EE463-Project-Group/EE463-Hardware-Project-2025/README.md

# EE 463 Hardware Project

## DC Motor Drive

**Partners:** 
- Kaan Demirkoparan
- Metin Özdemir
- Ali Tarık Birsoy
