EE463-Project-Group/EE463-Hardware-Project-2025/[01]Researches/Links.md

# Research Links:
---

## Homemade E-Bike Brushed DC Motor ESC | 36V Speed Controller:

- https://www.youtube.com/watch?v=GtXMHM78Xbo
- https://electronoobs.com/eng_arduino_tut126.php

---

## Homemade digital power supply with Arduino:

- https://www.youtube.com/watch?v=SAUsIR3VoN4
- https://electronoobs.com/eng_arduino_tut85.php

---

## Motor Speed Controller:

- https://tronicspro.com/dc-motor-speed-controller-150w-diy/

---

## Motor Speed Controller with Arduino:

- https://www.instructables.com/DIY-High-Current-Motor-Driver-h-bridge/?utm_source=chatgpt.com
- https://www.bristolwatch.com/ele5/index0.htm
- https://www.homemade-circuits.com/treadmill-motor-speed-controller-circuit/
- https://www.hackster.io/tareqwaleed1996/pid-speed-controller-for-dc-motor-74e735
- https://www.youtube.com/watch?v=RZIfzPwglOo
- https://www.youtube.com/watch?v=PlZitQysnUg&t=294s
- https://www.powerelectronicsnews.com/powerful-isolated-h-bridge-dc-motor-driver/
- https://www.youtube.com/watch?v=d0r-Yx9R3Zs&list=WL&index=8

### MC-2100 Motor Controller:

- https://forum.arduino.cc/t/another-treadmill-controller-question/676459/4
- https://sonsofinvention.wordpress.com/tag/mc-2100-motor-controller/
- https://www.dropbox.com/scl/fi/tmqcscf03akpz0rzh73zp/MC2100_rev_engrd.pdf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

### IR2110 Gate Driver:

- https://olegkutkov.me/2018/08/01/powerful-dc-motor-driver-using-ir2110/
- https://www.xecor.com/blog/ir2110-datasheet-pinout-features-and-applications
- https://www.youtube.com/watch?v=d0r-Yx9R3Zs&list=WL&index=8
- https://electronics.stackexchange.com/questions/229334/does-the-ir2110-need-a-gate-resistor

---

# Brushed DC Servo Drive:

- https://hackaday.io/project/9433-brushed-dc-servo-drive
- https://github.com/ottoragam/Tarocco
- 

---

## Arduino Library:

- https://github.com/ArminJo/PWMMotorControl
- https://github.com/evanlivingston/MC-2100-motor-speed-controller

## HV Floating MOS-Gate Driver ICs
- https://www.infineon.com/assets/row/public/documents/24/42/infineon-hv-floating-mos-gate-drivers-applicationnotes-en.pdf

## Motor Speed And Current Control:

- https://sites.google.com/site/hobbydebraj/dc-motor-control-using-back-emf-sen
- https://www.youtube.com/watch?v=QSIksPKndEs
- https://www.youtube.com/watch?v=HRaZLCBFVDE&t=157s
- https://www.youtube.com/watch?v=GqsONhTx7l0
- https://www.youtube.com/watch?v=DAeiA4D0j_I
- 

## Not Related But Could Be Useful:

- https://tronicspro.com/12v-220v-h-bridge-inverter-diy-homemade/
- https://www.hackster.io/saulius-bandzevicius/arduino-based-universal-ac-motor-speed-controller-a4ceaf
- https://www.youtube.com/watch?v=HRaZLCBFVDE
