EE463-Project-Group/EE463-Hardware-Project-2025/[01]Researches/image.png

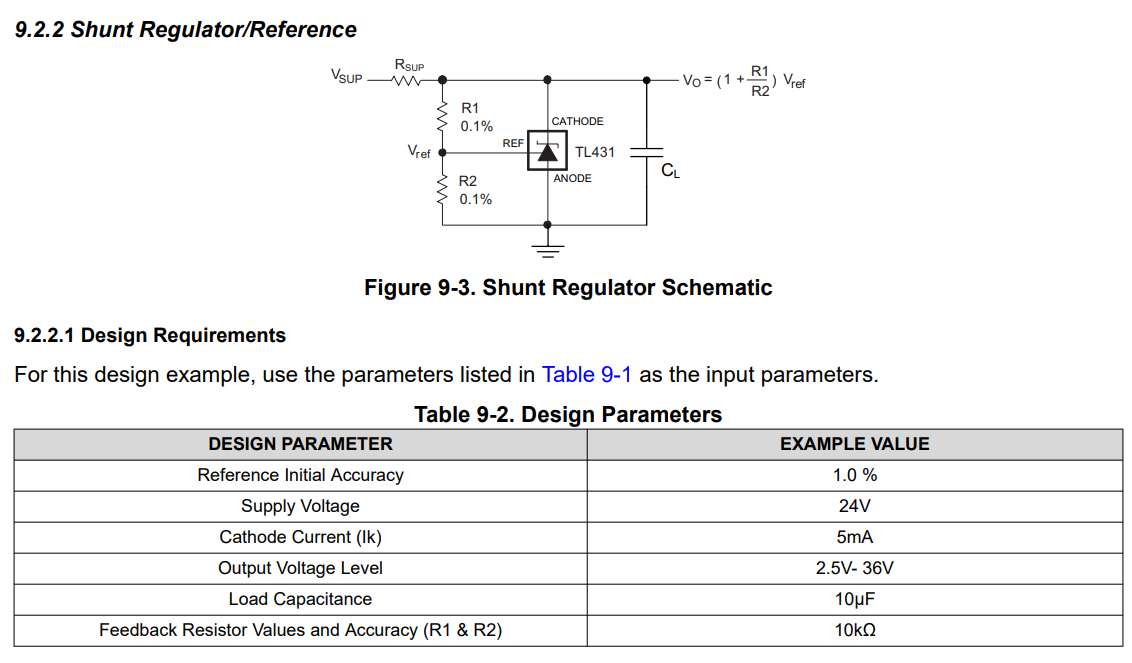
[01]Researches/image.png
