EE463-Project-Group/EE463-Hardware-Project-2025/[01]Researches/Component ReQ & List.md

# Mosfet (H Bridge):

## Requirements:
- For 180V motor Vds> 180v, but for voltage spikes and bemf reasons minimum %20 safety margin: Vds> 216V . But preferably Vds> 300V.
- For 2kw tea bonus: Id> 11A. Starting current etc. %200 safety margin: Id> 22A
- For 20KHz switching frequency: preferably Qg<100nC (https://gemini.google.com/share/17e45798b182)

## Models:
- IRF640N
  - https://www.infineon.com/assets/row/public/documents/24/49/infineon-irf640n-datasheet-en.pdf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
- IRFP250
  - https://www.vishay.com/docs/91212/irfp250.pdf
- PJMP120N60EC
  - 63 TL
  - https://www.ozdisan.com/api/pdf/product/assets/PANJIT_PJMP120N60EC.pdf
  - https://www.ozdisan.com/p/discrete-mosfetler-435/panjit-pjmp120n60ec-t0-00001-954296
- PJMH099N60EC
  - 74 TL
  - https://www.ozdisan.com/api/pdf/product/assets/PANJIT_PJMH099N60EC.pdf
  - https://www.ozdisan.com/p/discrete-mosfetler-435/panjit-pjmh099n60ec-995057
- PJMH074N60FRC
  - 129 TL
  - https://www.ozdisan.com/api/pdf/product/assets/PANJIT_PJMH074N60FRC.pdf
  - https://www.ozdisan.com/p/discrete-mosfetler-435/panjit-pjmh074n60frc-995056
- 
  -
- ASL101215
  -https://www.hatfon.com/urun/trafo-asl-101215-0-5va-2x15v-230v-aslan
  -https://www.pttavm.com/trafo-asl-0-5va-2x15-aslan-230v-p-114325137 (alternatif link)
  -
- 
  -
- 
  -
- 
  -
- 
  -
# Gate Driver:
## Models:
- IR2110
  - 57 TL (DIP)
  - https://www.motorobit.com/ir2110-dip-14-mosfet-driver-ic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
  - 36 TL (SMD)
  - https://www.ozdisan.com/p/guc-surucu-entegreleri-270/infineon-ir2110strpbf-483809
  - https://www.danomsk.ru/upload/iblock/01c/74860_0d2671659de625a9213c07e20588b5fd.pdf
