EE463-Project-Group/EE463-Hardware-Project-2025/[05]Docs/BOM List.xlsx

Model Name | Link | Price | Number For One Set | Number of Sets | Extra | Total Number | Total Price For Each Model | Datasheet Link
PJMH099N60EC | https://www.ozdisan.com/p/Discrete-Mosfets-435/panjit-pjmh099n60ec-995057 | 74.72 | 4 | 2 | 2 | 10 | ₺747.20 | PANJIT_PJMH099N60EC.pdf (https://www.ozdisan.com/api/pdf/product/assets/PANJIT_PJMH099N60EC.pdf)
MUR840 | https://www.komponentci.net/mur860-8a-600v-hizli-diyot-to-220ac-pmu10991 | 25.57 | 4 | 2 | 0 | 8 | ₺204.56 | MUR840, MUR860, RURP840, RURP860 8A, 400V - 600V Ultrafast Diodes (https://www.mouser.com/datasheet/2/149/rurp860-244175.pdf)
UF4007 | https://www.direnc.net/uf4007-10-amp-ultra-fast-rectifiers | 1.02 | 6 | 2 | 5 | 17 | ₺17.34 | uf4001.pdf (https://www.vishay.com/docs/88755/uf4001.pdf)
ADUM1200ARZ | ADUM1200ARZ-RL7 SOIC-8 2 Kanal İzolatör Entegresi ACS/AD/ADC Serisi Motorobit - Motorobit.com (https://www.motorobit.com/adum1200arz-rl7-soic-8-2-kanal-izolator-entegresi) | 104.4 | 2 | 1 | 1 | 3 | ₺313.20 | ADuM1200/ADuM1201 (Rev.K) (https://dosya.motorobit.com/pdf/ADUM1200ARZ.pdf)
Hall Effect Sensör | Hall Effect Sensör Kartı Manyetik Robolink (https://www.robolinkmarket.com/hall-effect-sensor-karti) | 14.4 | 1 | 1 | 1 | 2 | ₺28.80
5V 2A Adaptör | https://www.hepsiburada.com/oem-sl-1255-5v-2a-luks-filter-tablet-pc-adaptoru-p-HBCV00003ZC75G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 | 179.57 | 1 | 1 | 0 | 1 | ₺179.57
15V Adaptör |  |  |  |  |  | 0 | ₺0.00
18V 1A Adaptör | https://www.egbelektronik.com/urun/weko-18-volt-1-amper-5525-ulu-yerli-retim-priz-tipi-adaptr-11106511 | 98.14 | 4 | 1 | 0 | 4 | ₺392.56
1500 uF 400V C | 1500uF 400V Elektrolitik Kondansatör 35x82mm Elektrolit Kondansatör Motorobit - Motorobit.com (https://www.motorobit.com/1500uf-400v-elektrolitik-kondansator-35x82mm) | 448.92 | 1 | 1 | 1 | 2 | ₺897.84
0.1 uF 1kV C | RDER73A104K5B1H03B Murata - Kapasitörler - e-komponent.com (https://www.e-komponent.com/01-f-10-1000v-1kv-ceramic-capacitor) | 86.16 | 2 | 1 | 2 | 4 | ₺344.64
1N4118 Diyot | 1N4148 Diyot - MIC Uygun Fiyatıyla Satın Al - Direnc.net® (https://www.direnc.net/1n4148-diyot-mic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) | 0.41 | 2 | 1 | 5 | 7 | ₺2.87
100 nF C | 100nF 63V 5mm %5 Polyester Kondansatör Uygun Fiyatıyla Satın Al - Direnc.net® (https://www.direnc.net/100nf-63v-polyster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) | 1.78 | 13 | 1 | 10 | 23 | ₺40.94
10 uF | 10uF 100V Kondansatör 5x11mm Uygun Fiyatıyla Satın Al - Direnc.net® (https://www.direnc.net/10uf100v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) | 1.17 | 2 | 1 | 5 | 7 | ₺8.19
100uF | 100uF 16V Kondansatör 5mm 5x11mm 2000Hrs Uygun Fiyatıyla Satın Al - Direnc.net® (https://www.direnc.net/100uf-16v-kondansator-5x11-12485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) | 1.19 | 4 | 1 | 12 | 16 | ₺19.04
22uF (10 adet) | https://www.robolinkmarket.com/22uf-35v-kondansator-paketi-10-adet | 14.4 | 1 | 1 | 0 | 1 | ₺14.40
10k direnç (50 adet) | 10K 1/4W Direnç Uygun Fiyatıyla Satın Al - Direnc.net® (https://www.direnc.net/10k-14w-direnc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) | 0.15 | 1 | 1 | 29 | 30 | ₺4.50
10 ohm (50 adet) | 10R 1/4W Direnç Uygun Fiyatıyla Satın Al - Direnc.net® (https://www.direnc.net/10r-14w-direnc) | 0.15 | 4 | 1 | 46 | 50 | ₺7.50
1k (50 adet) | 1K 1/4W Direnç Uygun Fiyatıyla Satın Al - Direnc.net® (https://www.direnc.net/1k-14w-direnc) | 0.15 | 1 | 1 | 49 | 50 | ₺7.50
bc547 transistor (4 adet) | BC547- 100mA 45V TO92 NPN Transistörü Satın Al (https://www.robotistan.com/bc547-to92) | 1.55 | 2 | 1 | 4 | 6 | ₺9.30
27k direnç (50 adet) | 27K 1/4W Direnç Uygun Fiyatıyla Satın Al - Direnc.net® (https://www.direnc.net/27k-14w-direnc) | 0.15 | 1 | 1 | 49 | 50 | ₺7.50
560 ohm (50 adet) | https://www.direnc.net/560r-14w-direnc?language=tr&h=5f36deb5 | 0.15 | 4 | 1 | 46 | 50 | ₺7.50
IR2110 | IR2110 Mosfet Sürücü Entegresi Dip-14 | Komponentci (https://www.komponentci.net/ir2110-mosfet-surucu-entegresi-dip-14-pmu8539) | 80.13 | 2 | 1 | 6 | 8 | ₺641.04
acs712 | https://www.robotistan.com/acs712-akim-sensoru-current-sensor-carrier-30-to-30a?language=tr&h=4d66867c | 74.43 | 1 | 1 | 1 | 2 | ₺148.86
6n135 | 6N135 DIP-8 Transistör Çıkışlı Optokuplör Entegresi Uygun Fiyatıyla Satın Al - Direnc.net® (https://www.direnc.net/6n135-high-speed-transistor-optocouplers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) | 24.95 | 2 | 1 | 4 | 6 | ₺149.70
Elektrik Kutusu |  |  |  |  |  | 0 | ₺0.00
230v Plug | https://www.motorobit.com/kulakli-erkek-power-soketi-isikli-anahtarli | 44.37 | 1 | 1 | 0 | 1 | ₺44.37
Buton | https://www.motorobit.com/arduino-5li-buton-modulu | 78.3 | 1 | 1 | 0 | 1 | ₺78.30
Direction Switch | https://www.komponentci.net/ic-140-toggle-switch-on-off-on-6mm-3p-mts-103-pmu6948 | 16.08 | 1 | 1 | 0 | 1 | ₺16.08
On Off Switch 230V | https://www.direnc.net/dc134d-3p-on-off-anahtar-220v-15mm-isikli-yuvarlak?language=tr&h=ff36214d | 23.83 | 1 | 1 | 0 | 1 | ₺23.83
14 pin entegre soketi | https://www.komponentci.net/14-pin-entegre-soketi-pmu3014 | 1.01 | 2 | 1 | 6 | 8 | ₺8.08
8 pin entegre soketi | https://www.komponentci.net/8-pin-entegre-soketi-pmu3015 | 0.88 | 2 | 1 | 4 | 6 | ₺5.28
Total Price Sum |  |  |  |  |  |  | ₺4370.49
Sponsorship Amount |  |  |  |  | $100.00 | 42.54 | ₺4254.00
Net Money |  |  |  |  |  |  | -₺116.49
