EE463-Project-Group/EE463-Hardware-Project-2025/[01]Researches/Component List.xlsx

Ürün Adı | Link | Fiyat | Adet | datasheet link
PJMH099N60EC | https://www.ozdisan.com/p/Discrete-Mosfets-435/panjit-pjmh099n60ec-995057 | 74.7263 | 4*2 | PANJIT_PJMH099N60EC.pdf (https://www.ozdisan.com/api/pdf/product/assets/PANJIT_PJMH099N60EC.pdf)
MUR840 |  |  | 4*3 | MUR840, MUR860, RURP840, RURP860 8A, 400V - 600V Ultrafast Diodes (https://www.mouser.com/datasheet/2/149/rurp860-244175.pdf)
UF4007 |  |  | 6*2 | uf4001.pdf (https://www.vishay.com/docs/88755/uf4001.pdf)
ADUM1200ARZ | ADUM1200ARZ-RL7 SOIC-8 2 Kanal İzolatör Entegresi ACS/AD/ADC Serisi Motorobit - Motorobit.com (https://www.motorobit.com/adum1200arz-rl7-soic-8-2-kanal-izolator-entegresi) | 104.4 | 2 +1 | ADuM1200/ADuM1201 (Rev.K) (https://dosya.motorobit.com/pdf/ADUM1200ARZ.pdf)
Hall Effect Sensör | Hall Effect Sensör Kartı Manyetik Robolink (https://www.robolinkmarket.com/hall-effect-sensor-karti) | 14.4 | 1+1
5V 2A Adaptör
15V Adaptör
18V 1A Adaptör | Uydu Alıcı Sistemleri ve Elektronik Mağazası - Merterelektronik.com (https://www.merterelektronik.com/weko-18-volt-1-amper-priz-tip-5.5x2.5-uc-adaptor) | 144.6 | 1
1500 uF 400V C | 1500uF 400V Elektrolitik Kondansatör 35x82mm Elektrolit Kondansatör Motorobit - Motorobit.com (https://www.motorobit.com/1500uf-400v-elektrolitik-kondansator-35x82mm) | 448.92 | 1+1
0.1 uF 1kV C | RDER73A104K5B1H03B Murata - Kapasitörler - e-komponent.com (https://www.e-komponent.com/01-f-10-1000v-1kv-ceramic-capacitor) | 86.16
1N4118 Diyot | 1N4148 Diyot - MIC Uygun Fiyatıyla Satın Al - Direnc.net® (https://www.direnc.net/1n4148-diyot-mic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) | 0.41 | 2+1
100 nF C | 100nF 63V 5mm %5 Polyester Kondansatör Uygun Fiyatıyla Satın Al - Direnc.net® (https://www.direnc.net/100nf-63v-polyster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) | 1.78 | 13+3
10 uF | 10uF 100V Kondansatör 5x11mm Uygun Fiyatıyla Satın Al - Direnc.net® (https://www.direnc.net/10uf100v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) | 1.17 | 2+1
100uF | 100uF 16V Kondansatör 5mm 5x11mm 2000Hrs Uygun Fiyatıyla Satın Al - Direnc.net® (https://www.direnc.net/100uf-16v-kondansator-5x11-12485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) | 1.19 | 4+1
20uF
10k direnç | 10K 1/4W Direnç Uygun Fiyatıyla Satın Al - Direnc.net® (https://www.direnc.net/10k-14w-direnc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) | 0.15 | 1+1 (min50)
10 ohm | 10R 1/4W Direnç Uygun Fiyatıyla Satın Al - Direnc.net® (https://www.direnc.net/10r-14w-direnc) | 0.15 | 4+1 (min 50)
1k | 1K 1/4W Direnç Uygun Fiyatıyla Satın Al - Direnc.net® (https://www.direnc.net/1k-14w-direnc) | 0.15 | 4+1 (min50)
bc547 transistor | BC547- 100mA 45V TO92 NPN Transistörü Satın Al (https://www.robotistan.com/bc547-to92) | 1.55 | 2+1
27k direnç | 27K 1/4W Direnç Uygun Fiyatıyla Satın Al - Direnc.net® (https://www.direnc.net/27k-14w-direnc) | 0.15 | 1 +1 (min 50)
570 ohm |  |  | 4+1
IR2110 | IR2110 Mosfet Sürücü Entegresi Dip-14 | Komponentci (https://www.komponentci.net/ir2110-mosfet-surucu-entegresi-dip-14-pmu8539) | 80.13 | 2+2
acs712 | ACS712-30A Smd Akım Sensörü Entegresi Soic-8 Uygun Fiyatıyla Satın Al - Direnc.net® (https://www.direnc.net/acs712-30a-smd-akim-sensoru-entegresi-soic8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) | 71.1 | 1+1
6n135 | 6N135 DIP-8 Transistör Çıkışlı Optokuplör Entegresi Uygun Fiyatıyla Satın Al - Direnc.net® (https://www.direnc.net/6n135-high-speed-transistor-optocouplers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) | 24.95 | 2+1
