EE463-Project-Group/EE463-Hardware-Project-2025/.github/commit-instructions.md

Commit mesajlarının daima şu formatta olmasını sağla: [ANA_KLASÖR_ADI]: Açıklayıcı Başlık.
ANA_KLASÖR_ADI, yapılan değişikliklerin en çok bulunduğu klasör olmalıdır (örn: Researches, Designs, Softwares, Simulations).
Açıklayıcı Başlık, daha önceki commitlere benzer şekilde yapılan çalışmayı çok kısa özetleyecek şekilde olmalıdır.
Başlık 50 karakteri geçmemelidir.
