EE463-Project-Group/EE463-Hardware-Project-2025/[02]Designs/KiCad Design/Schematic.pdf

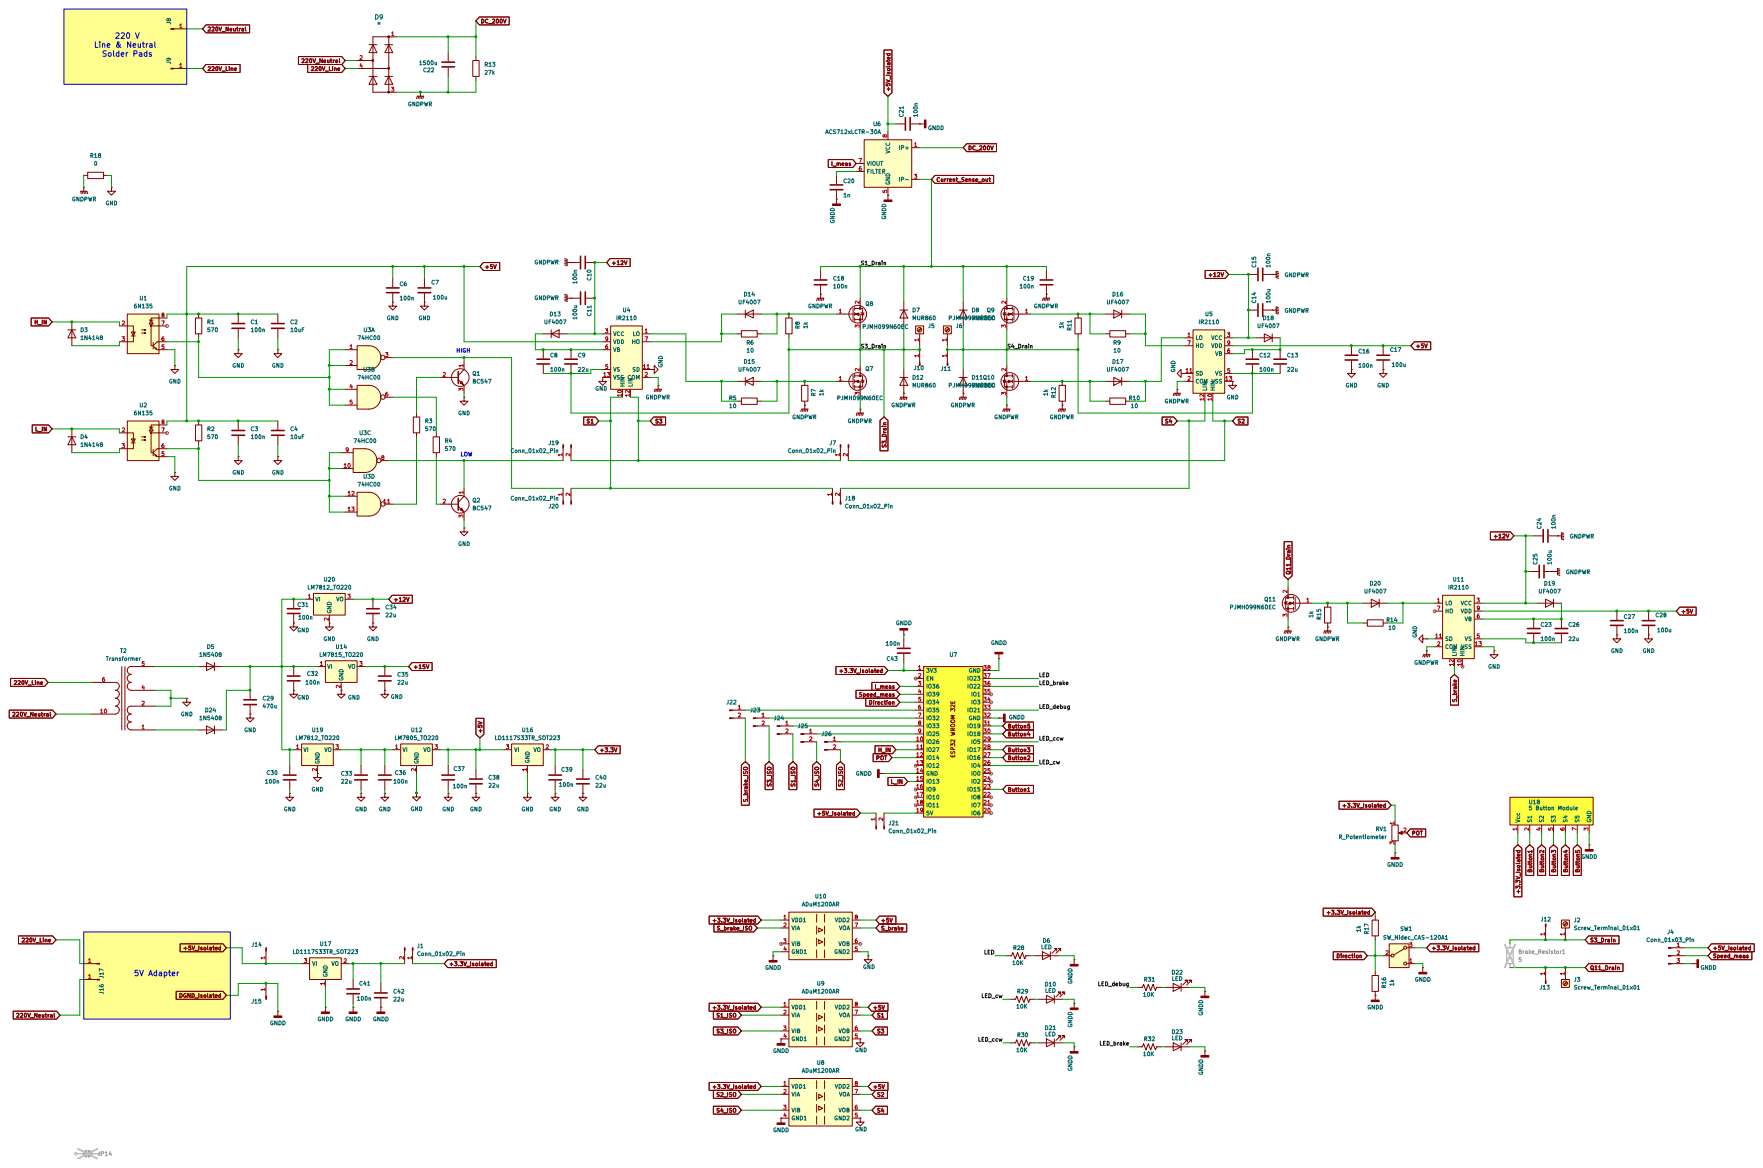
[picture p30: page 1]
