EE463-Project-Group/EE463-Hardware-Project-2025/[04]Simulations/Auxilary Power/low_voltage_gen.asc

C1: cap; 4700µ
C2: cap; 10µ
D1: diode; 1N4007
D2: diode; 1N4007
L1: ind2; 100
L2: ind2; 1
L3: ind2; 1
R1: res; 1
R2: res; 1k
R3: res; 1k
R4: res; 3k
U1: 7805
U2: 7812
U3: 7815
U4: TL431
V1: voltage; SINE(0 200 50)
Named nets: 0, 3.3v, 15v, 5v, 12v
K L1 L2 L3 1
.tran 1
