EE463-Project-Group/EE463-Hardware-Project-2025/[02]Designs/KiCad Design/463 term project.kicad_pcb

## KiCad design [02]Designs/KiCad Design/463 term project.kicad_pcb (2026-01-02)

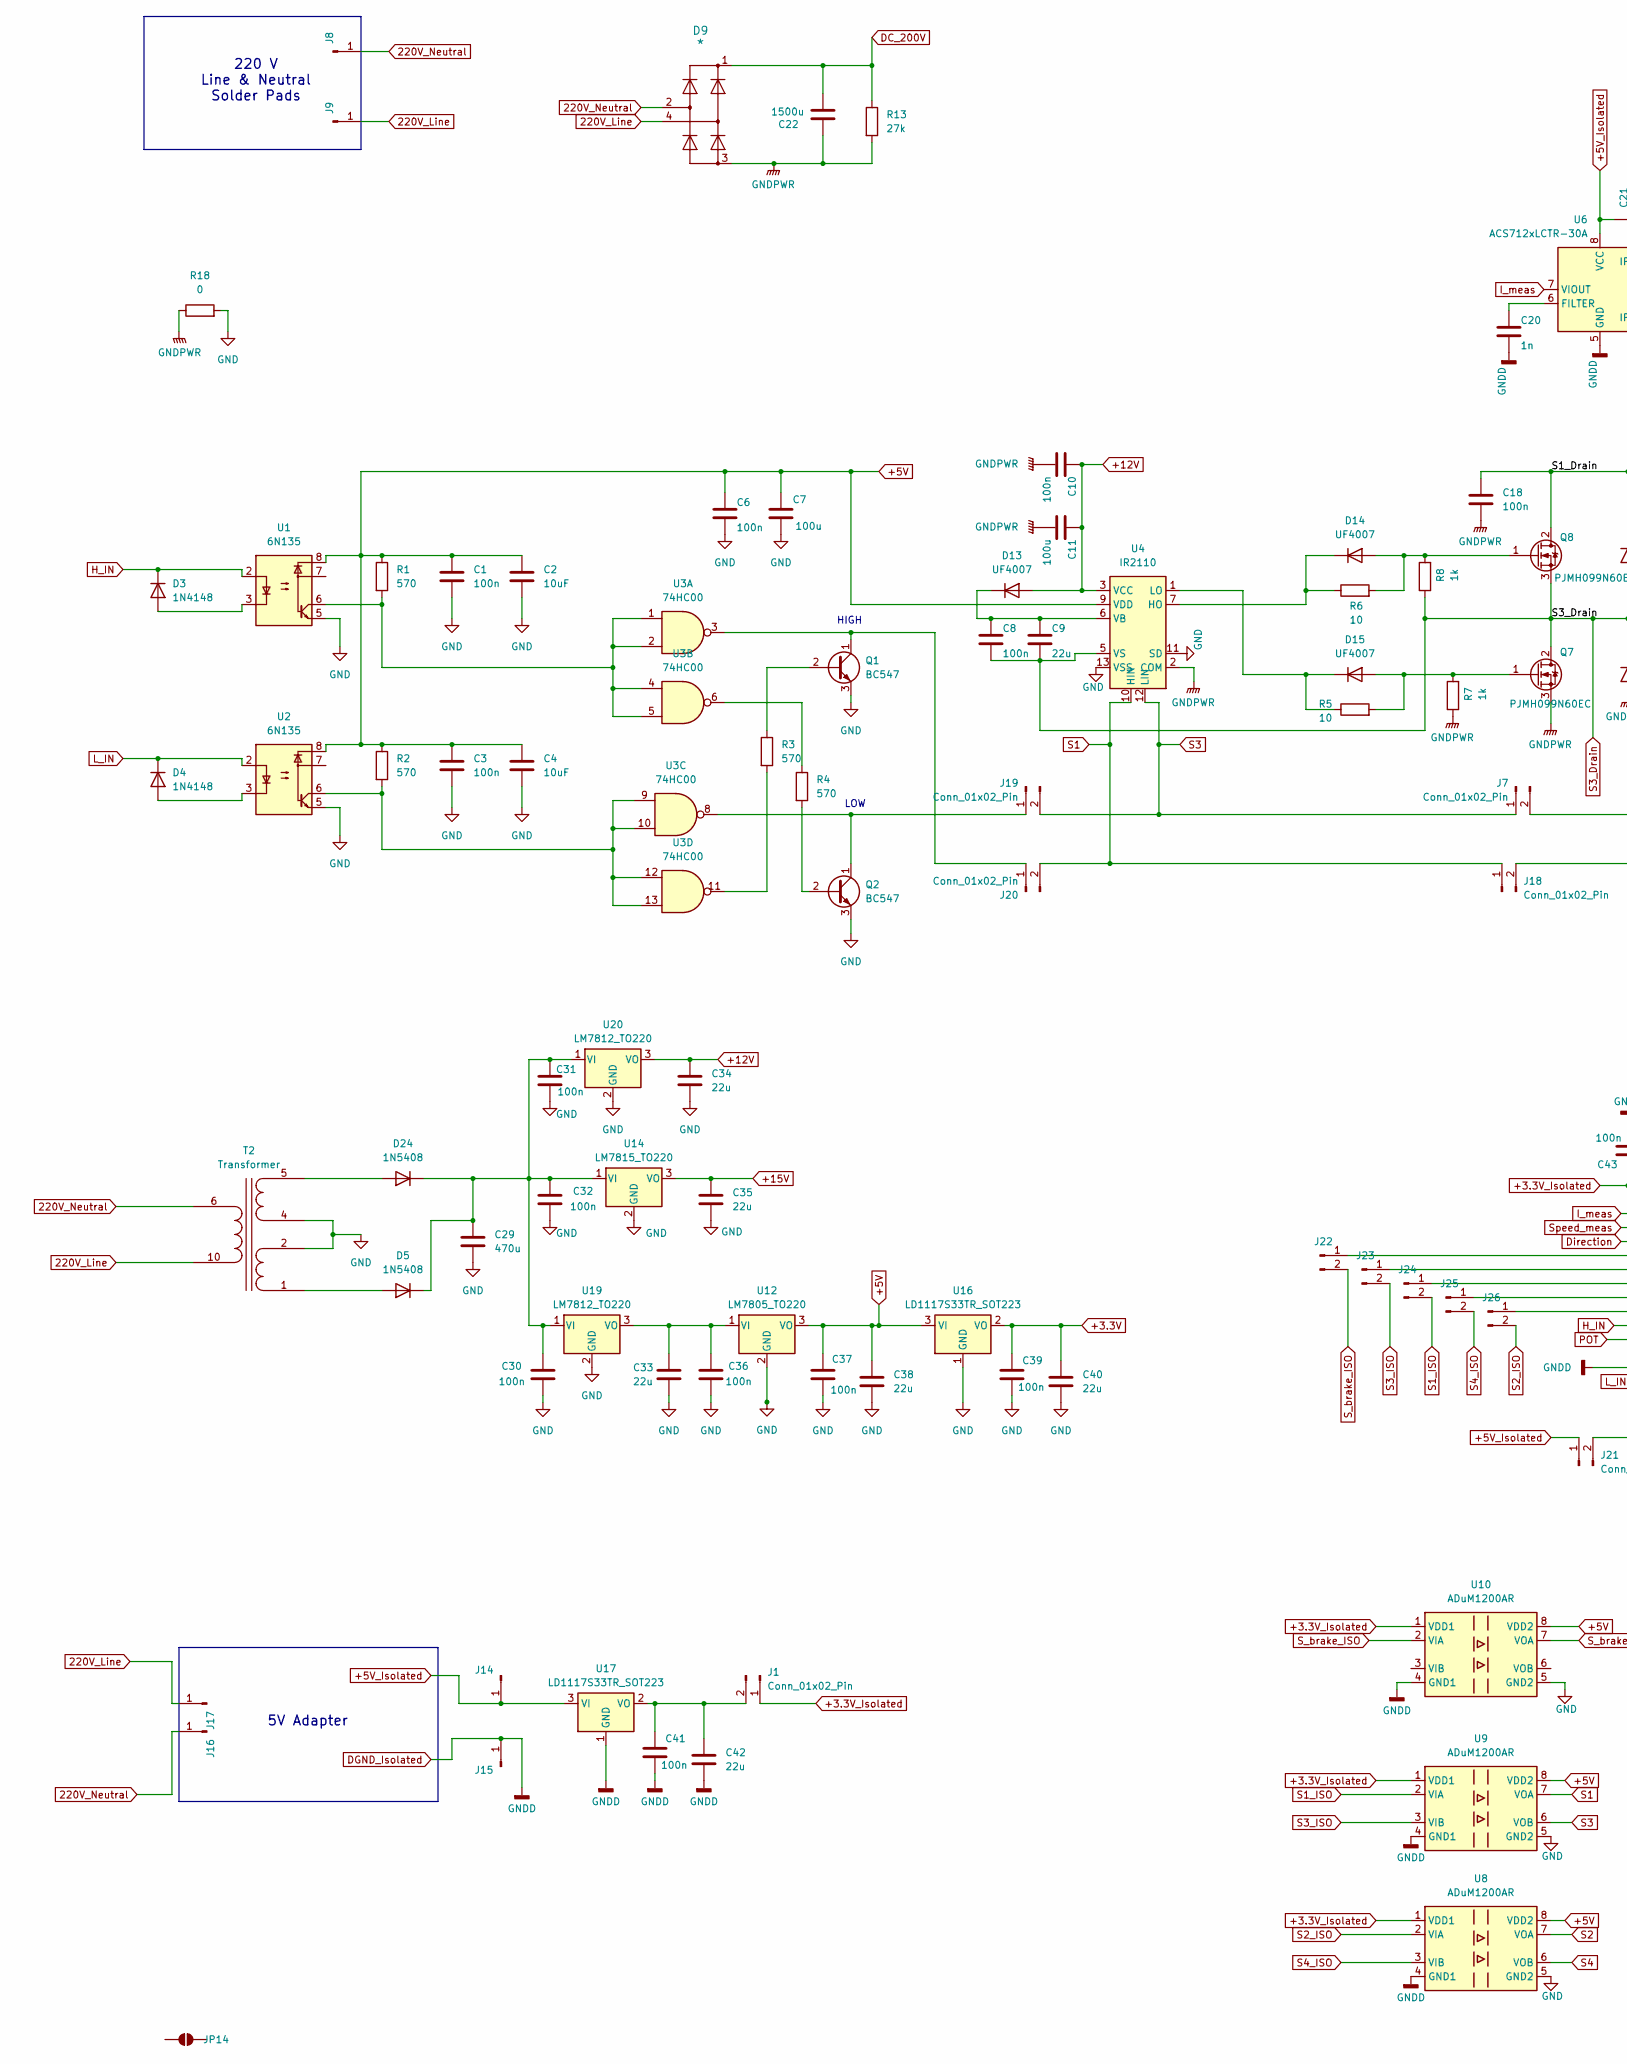
[picture p31: schematic 463 term project.kicad_sch, part in row 1, column 1]

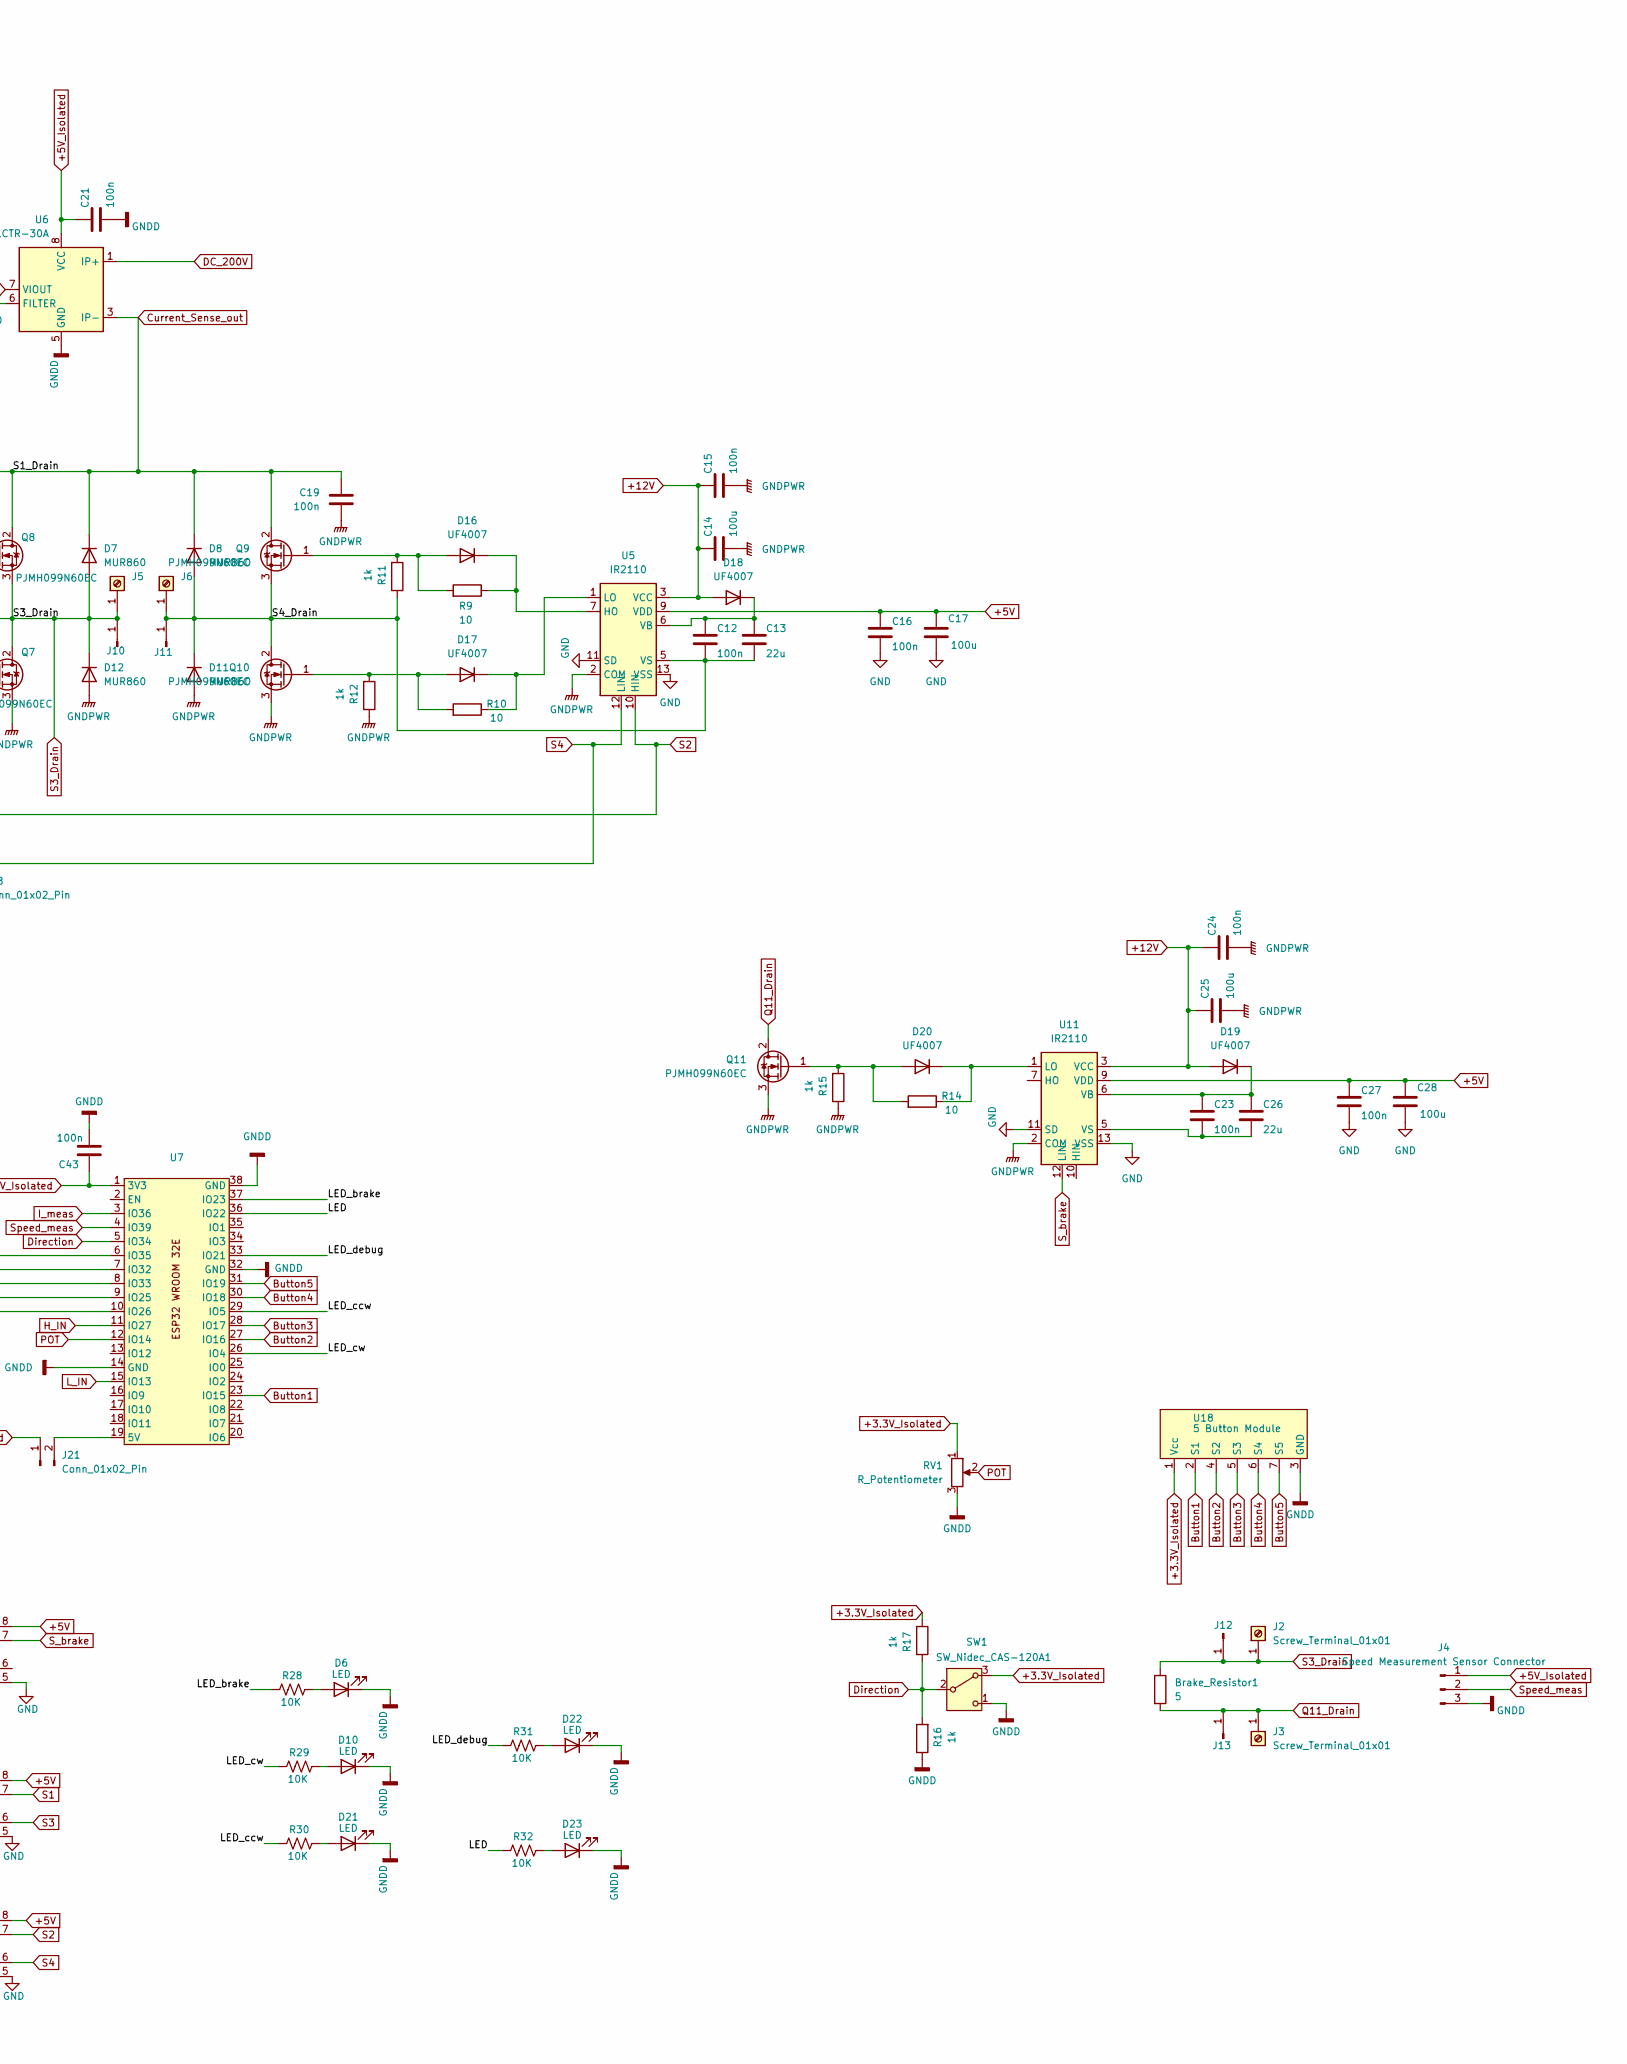
[picture p32: schematic 463 term project.kicad_sch, part in row 1, column 2]

Parts:
Brake_Resistor1: 5
C1, C3, C6, C8, C10, C12, C15, C16, C18, C19, C23, C24, C27, C30, C31, C32, C36, C37, C39, C41, C43: 100n; C_Disc_D5.0mm_W2.5mm_P5.00mm
C2, C4: 10uF; CP_Radial_D6.3mm_P2.50mm
C7, C11, C14, C17, C25, C28: 100u; CP_Radial_D8.0mm_P5.00mm
C9, C13, C26, C33, C34, C35, C38, C40, C42: 22u; CP_Radial_D8.0mm_P5.00mm
C20: 1n; 0603 Large
C21: 100n; 0603 Large
C22: 1500u; 1500uF
C29: 470u; CP_Radial_D10.0mm_P2.50mm
D3, D4: 1N4148; D_DO-35_SOD27_P7.62mm_Horizontal
D5, D24: 1N5408; D_DO-201AD_P15.24mm_Horizontal
D6, D10, D21, D22, D23: LED; 0603 Medium
D7, D8, D11, D12: MUR860; TO-220-2_Vertical
D9: *; KBPC3510FP
D13, D14, D15, D16, D17, D18, D19, D20: UF4007; D_DO-41_SOD81_P10.16mm_Horizontal
J1, J7, J18, J19, J20, J21, J22, J23, J24, J25, J26: Conn_01x02_Pin; PinHeader_1x02_P2.54mm_Vertical
J2, J3, J5, J6: Screw_Terminal_01x01; Untitled
J4: Speed Measurement Sensor Connector; PinHeader_1x03_P2.54mm_Vertical
J8, J9, J10, J11, J12, J13, J16, J17: Conn_01x01_Pin; SolderWirePad_1x01_SMD_5x10mm
J14, J15: Conn_01x01_Pin; SolderWirePad_1x01_SMD_1x2mm
JP14: SolderJumper_2_Open; SolderJumper-2_P1.3mm_Open_TrianglePad1.0x1.5mm
Q1, Q2: BC547; TO-92_Inline
Q7, Q8, Q9, Q10, Q11: PJMH099N60EC; TO-247-3_Vertical
R1, R2, R3, R4: 570; R_Axial_DIN0207_L6.3mm_D2.5mm_P10.16mm_Horizontal
R5, R6, R9, R10, R14: 10; R_Axial_DIN0207_L6.3mm_D2.5mm_P10.16mm_Horizontal
R7, R8, R11, R12, R15, R16, R17: 1k; R_Axial_DIN0207_L6.3mm_D2.5mm_P10.16mm_Horizontal
R13: 27k; R_Axial_DIN0207_L6.3mm_D2.5mm_P10.16mm_Horizontal
R18: 0; R_Axial_DIN0207_L6.3mm_D2.5mm_P10.16mm_Horizontal
R28, R29, R30, R31, R32: 10K; 0603 Medium
RV1: R_Potentiometer; PinHeader_1x03_P2.54mm_Vertical
SW1: SW_Nidec_CAS-120A1; PinHeader_1x03_P2.54mm_Vertical
T2: Transformer; Transformer_Breve_TEZ-35x42
U1, U2: 6N135; DIP-8_W7.62mm
U3: 74HC00; DIP-14_W7.62mm_Socket
U4, U5, U11: IR2110; DIP-14_W7.62mm
U6: ACS712xLCTR-30A; SOIC-8_3.9x4.9mm_P1.27mm
U7: ESP32_WROOM_32X
U8, U9, U10: ADuM1200AR; SOIC-8_3.9x4.9mm_P1.27mm
U12: LM7805_TO220; TO-220-3_Vertical
U14: LM7815_TO220; TO-220-3_Vertical
U16, U17: LD1117S33TR_SOT223; TO-220-3_Vertical
U18: 5 Button Module; 5 button module
U19, U20: LM7812_TO220; TO-220-3_Vertical

Connections:
220V_Line: D9.4 (Input_~), J9.1, J17.1, T2.10 (AB)
220V_Neutral: D9.2 (Input_~), J8.1, J16.1, T2.6 (AA)
+3.3V: C39.1, C40.1, U16.2 (VO)
+3.3V_Isolated: C43.1, J1.1, R17.1, RV1.1, SW1.3 (A), U7.1 (3V3), U8.1 (VDD1), U9.1 (VDD1), U10.1 (VDD1), U18.1 (Vcc)
+5V: C1.1, C2.1, C3.1, C4.1, C6.1, C7.1, C16.1, C17.1, C27.1, C28.1, C37.1, C38.1, R1.1, R2.1, U1.8, U2.8, U4.9 (VDD), U5.9 (VDD), U8.8 (VDD2), U9.8 (VDD2), U10.8 (VDD2), U11.9 (VDD), U12.3 (VO), U16.3 (VI)
+5V_Isolated: C21.1, J4.1, J14.1, J21.1, U6.8 (VCC), U17.3 (VI)
+12V: C10.1, C11.1, C14.1, C15.1, C24.1, C25.1, C34.1, D13.2 (A), D18.2 (A), D19.2 (A), U4.3 (VCC), U5.3 (VCC), U11.3 (VCC), U20.3 (VO)
+15V: C35.1, U14.3 (VO)
/LED: R32.1, U7.36 (IO22)
/LED_brake: R28.1, U7.37 (IO23)
/LED_ccw: R30.1, U7.29 (IO5)
/LED_cw: R29.1, U7.26 (IO4)
/LED_debug: R31.1, U7.33 (IO21)
/S4_Drain: C12.2, C13.2, D8.2 (A), D11.1 (K), J6.1, J11.1, Q9.3 (S), Q10.2 (D), R11.1, U5.5 (VS)
Button1: U7.23 (IO15), U18.2 (S1)
Button2: U7.27 (IO16), U18.4 (S2)
Button3: U7.28 (IO17), U18.5 (S3)
Button4: U7.30 (IO18), U18.6 (S4)
Button5: U7.31 (IO19), U18.7 (S5)
Current_Sense_out: C18.1, C19.1, D7.1 (K), D8.1 (K), Q8.2 (D), Q9.2 (D), U6.3 (IP-), U6.4 (IP-)
DC_200V: C22.2, D9.1 (+), R13.1, U6.1 (IP+), U6.2 (IP+)
DGND_Isolated: C20.2, C21.2, C41.2, C42.2, C43.2, D6.1 (K), D10.1 (K), D21.1 (K), D22.1 (K), D23.1 (K), J4.3, J15.1, R16.1, RV1.3, SW1.1 (C), U6.5 (GND), U7.14 (GND), U7.32 (GND), U7.38 (GND), U8.4 (GND1), U9.4 (GND1), U10.4 (GND1), U17.1 (GND), U18.3 (GND)
Direction: R16.2, R17.2, SW1.2 (B), U7.5 (IO34)
GND: C1.2, C2.2, C3.2, C4.2, C6.2, C7.2, C16.2, C17.2, C27.2, C28.2, C29.2, C30.2, C31.2, C32.2, C33.2, C34.2, C35.2, C36.2, C37.2, C38.2, C39.2, C40.2, Q1.3 (E), Q2.3 (E), R18.2, T2.2 (SC), T2.4 (SB), U1.5, U2.5, U4.11 (SD), U4.13 (VSS), U5.11 (SD), U5.13 (VSS), U8.5 (GND2), U9.5 (GND2), U10.5 (GND2), U11.11 (SD), U11.13 (VSS), U12.2 (GND), U14.2 (GND), U16.1 (GND), U19.2 (GND), U20.2 (GND)
GNDPWR: C10.2, C11.2, C14.2, C15.2, C18.2, C19.2, C22.1, C24.2, C25.2, D9.3 (-), D11.2 (A), D12.2 (A), Q7.3 (S), Q10.3 (S), Q11.3 (S), R7.1, R12.1, R13.2, R15.1, R18.1, U4.2 (COM), U5.2 (COM), U11.2 (COM)
H_IN: D3.1 (K), U1.2, U7.11 (IO27)
I_meas: U6.7 (VIOUT), U7.3 (IO36)
L_IN: D4.1 (K), U2.2, U7.15 (IO13)
unnamed: D3.2 (A), U1.3
unnamed: D4.2 (A), U2.3
unnamed: D5.2 (A), T2.1 (SD)
unnamed: D6.2 (A), R28.2
unnamed: D10.2 (A), R29.2
unnamed: C8.1, C9.1, D13.1 (K), U4.6 (VB)
unnamed: D14.2 (A), Q8.1 (G), R6.2, R8.2
unnamed: D14.1 (K), R6.1, U4.7 (HO)
unnamed: D15.2 (A), Q7.1 (G), R5.2, R7.2
unnamed: D15.1 (K), R5.1, U4.1 (LO)
unnamed: D16.2 (A), Q9.1 (G), R9.2, R11.2
unnamed: D16.1 (K), R9.1, U5.7 (HO)
unnamed: D17.2 (A), Q10.1 (G), R10.2, R12.2
unnamed: D17.1 (K), R10.1, U5.1 (LO)
unnamed: C12.1, C13.1, D18.1 (K), U5.6 (VB)
unnamed: C23.1, C26.1, D19.1 (K), U11.6 (VB)
unnamed: D20.2 (A), Q11.1 (G), R14.2, R15.2
unnamed: D20.1 (K), R14.1, U11.1 (LO)
unnamed: D21.2 (A), R30.2
unnamed: D22.2 (A), R31.2
unnamed: D23.2 (A), R32.2
unnamed: D24.2 (A), T2.5 (SA)
unnamed: C29.1, C30.1, C31.1, C32.1, D5.1 (K), D24.1 (K), U14.1 (VI), U19.1 (VI), U20.1 (VI)
unnamed: C41.1, C42.1, J1.2, U17.2 (VO)
unnamed: J19.1, Q2.1 (C), U3.8
unnamed: J20.1, Q1.1 (C), U3.3
unnamed: J21.2, U7.19 (5V)
unnamed: J22.1, U7.6 (IO35)
unnamed: J23.1, U7.7 (IO32)
unnamed: J24.1, U7.8 (IO33)
unnamed: J25.1, U7.9 (IO25)
unnamed: J26.1, U7.10 (IO26)
unnamed: Q1.2 (B), R3.1
unnamed: Q2.2 (B), R4.2
unnamed: R1.2, U1.6, U3.1, U3.2, U3.4, U3.5
unnamed: R2.2, U2.6, U3.9, U3.10, U3.12, U3.13
unnamed: R3.2, U3.11
unnamed: R4.1, U3.6
unnamed: C20.1, U6.6 (FILTER)
unnamed: C23.2, C26.2, U11.5 (VS)
unnamed: C33.1, C36.1, U12.1 (VI), U19.3 (VO)
POT: RV1.2, U7.12 (IO14)
Q11_Drain: Brake_Resistor1.2, J3.1, J13.1, Q11.2 (D)
S1: J18.1, J20.2, U4.10 (HIN), U9.7 (VOA)
S1_ISO: J24.2, U9.2 (VIA)
S2: J7.2, U5.10 (HIN), U8.7 (VOA)
S2_ISO: J26.2, U8.2 (VIA)
S3: J7.1, J19.2, U4.12 (LIN), U9.6 (VOB)
S3_Drain: Brake_Resistor1.1, C8.2, C9.2, D7.2 (A), D12.1 (K), J2.1, J5.1, J10.1, J12.1, Q7.2 (D), Q8.3 (S), R8.1, U4.5 (VS)
S3_ISO: J23.2, U9.3 (VIB)
S4: J18.2, U5.12 (LIN), U8.6 (VOB)
S4_ISO: J25.2, U8.3 (VIB)
S_brake: U10.7 (VOA), U11.12 (LIN)
S_brake_ISO: J22.2, U10.2 (VIA)
Speed_meas: J4.2, U7.4 (IO39)

Notes on the sheet:
220 V Line & Neutral Solder Pads
HIGH
LOW
5V Adapter

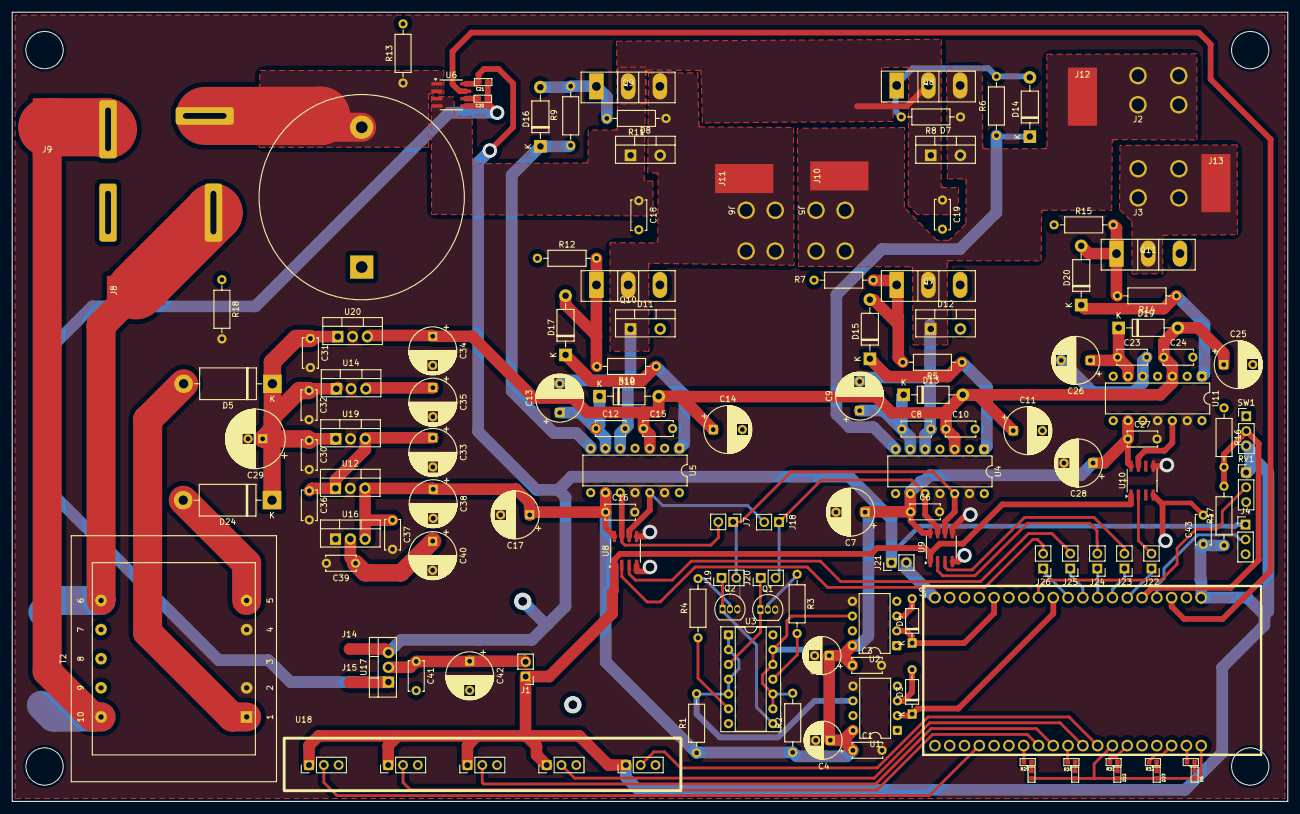
[picture p33: board 463 term project.kicad_pcb from above]

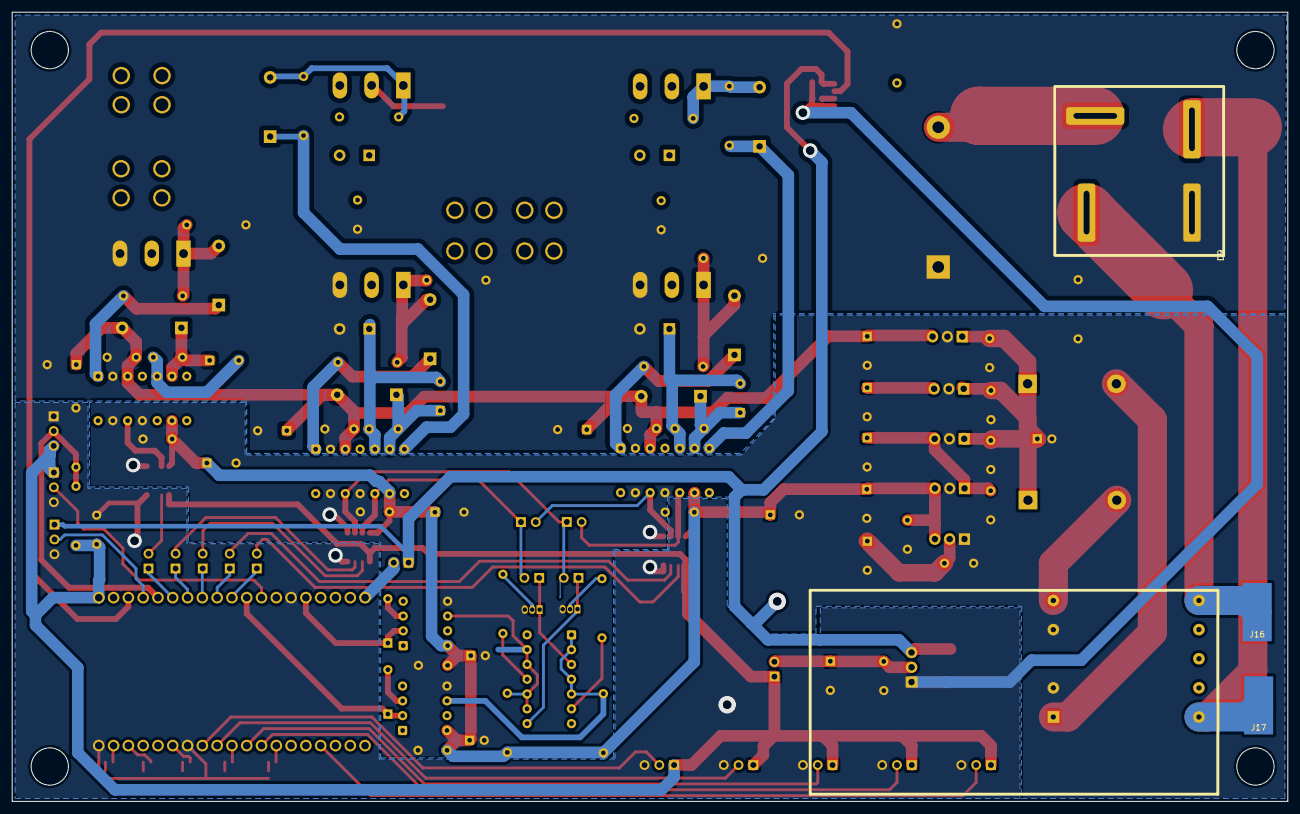
[picture p34: board 463 term project.kicad_pcb from below]

Board: 2 copper layers, 219.0 x 135.5 mm, 141 parts (3 on the bottom side), 83 nets.
