EE463-Project-Group/EE463-Hardware-Project-2025/(commit log)

2025-11-24 [Researches] Add various research links for motor controllers
2025-11-25 [Researches] Update Links.md with new resources and corrections
    Added new links for brushed DC servo drive and updated MC-2100 Motor Controller section.
2025-11-25 fully discrete buck design
    buck design report which I did during my internship, might prove useful
2025-12-01 Add HV Floating MOS-Gate Driver ICs section
    Added a section for HV Floating MOS-Gate Driver ICs with a relevant link.
2025-12-01 simple dc motor starter design
    without PI controller
2025-12-03 [Researches] Update Links.md with new resources
    Added new resources for IR2110 Gate Driver and Motor Speed Control.
2025-12-03 [Researches] Update Links.md with new resources
    Added additional YouTube links for motor speed and current control.
2025-12-03 [Researches] Component List Mosfet and Gate Driver Added
    Added detailed specifications and models for Mosfet and Gate Driver components.
2025-12-03 [Researches] Updated component list
    Added a reference link for Qg specification at 20KHz switching frequency.
2025-12-04 Designs: Low Voltage Generation
    5,12,15, 3.3v generated. Note: need to download necessary models to ltspice
2025-12-05 Simulations: auxiliary power stage
2025-12-05 Designs: Auxiliary power stage
2025-12-06 Add new file 'a' in KiCad Designs directory
2025-12-06 Schematic Design of Motor Controller
    [463 term project.kicad_pcb, 463 term project.kicad_sch]
2025-12-07 Component list
    [Component List.xlsx]
2025-12-07 [Docs] Added BOM list
    Added BOM List.xlsx to the Docs folder. Renamed preliminary design presentation and report files from [05]Reports to [06]Reports for better organization. Added KiCad schematic lock file.
    [BOM List.xlsx]
2025-12-07 Update BOM List.xlsx
    [BOM List.xlsx]
2025-12-18 Schematic Updates: Added Brake Part
    auxlary power design added
    [463 term project.kicad_sch, BOM List.xlsx, aux_power.kicad_sch]
2025-12-18 Schematic and Footprints are finished
    [463 term project.kicad_pcb, 463 term project.kicad_sch, aux_power.kicad_sch]
2025-12-19 schematic is updated
    [463 term project.kicad_sch]
2025-12-19 Layout.v1 finished & Schematic updates
    [463 term project.kicad_pcb, 463 term project.kicad_sch]
2025-12-21 Layout and schematic updates
    [463 term project.kicad_pcb, 463 term project.kicad_sch]
2025-12-21 [Design] Layout Finished
    [463 term project.kicad_pcb, 463 term project.kicad_sch]
2025-12-22 [Design] Layout Finalized
    [463 term project.kicad_pcb, 463 term project.kicad_sch]
2025-12-22 Updates on Layout and Schematic
    [463 term project.kicad_pcb, 463 term project.kicad_sch]
2025-12-22 Updates on Layout
    [463 term project.kicad_pcb]
2025-12-24 Added Schematic PDF
2025-12-25 Update 463 term project.kicad_prl
2025-12-26 Reduced PCB Size
    This reverts commit fabae2b9b95dacba0e962aa67e5fb78db473a071.
    [463 term project.kicad_pcb, 463 term project.kicad_sch]
2025-12-30 Updated Simulation & Uploaded First Working ESP Code
    [463 term project-B_Cu.gbr, 463 term project-Edge_Cuts.gbr, 463 term project-F_Cu.gbr, 463 term project-NPTH.drl, 463 term project-PTH.drl, 463 term project-job.gbrjob]
2025-12-30 Minor PCB Shematic Correction & File Arrangements
    [463 term project.kicad_pcb, 463 term project.kicad_sch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]
2026-01-02 Schematic Update & New Software Update (LED and Buttons Added)
    [463 term project.kicad_pcb, 463 term project.kicad_sch]
2026-01-06 Update Software. LEDs and Buttons Work
